Ethereal-Space-Inc/esi-science-card-hardware/mcxn-proto-card/oresat-proto-card.kicad_pcb

## KiCad design mcxn-proto-card/oresat-proto-card.kicad_pcb (2026-07-07)

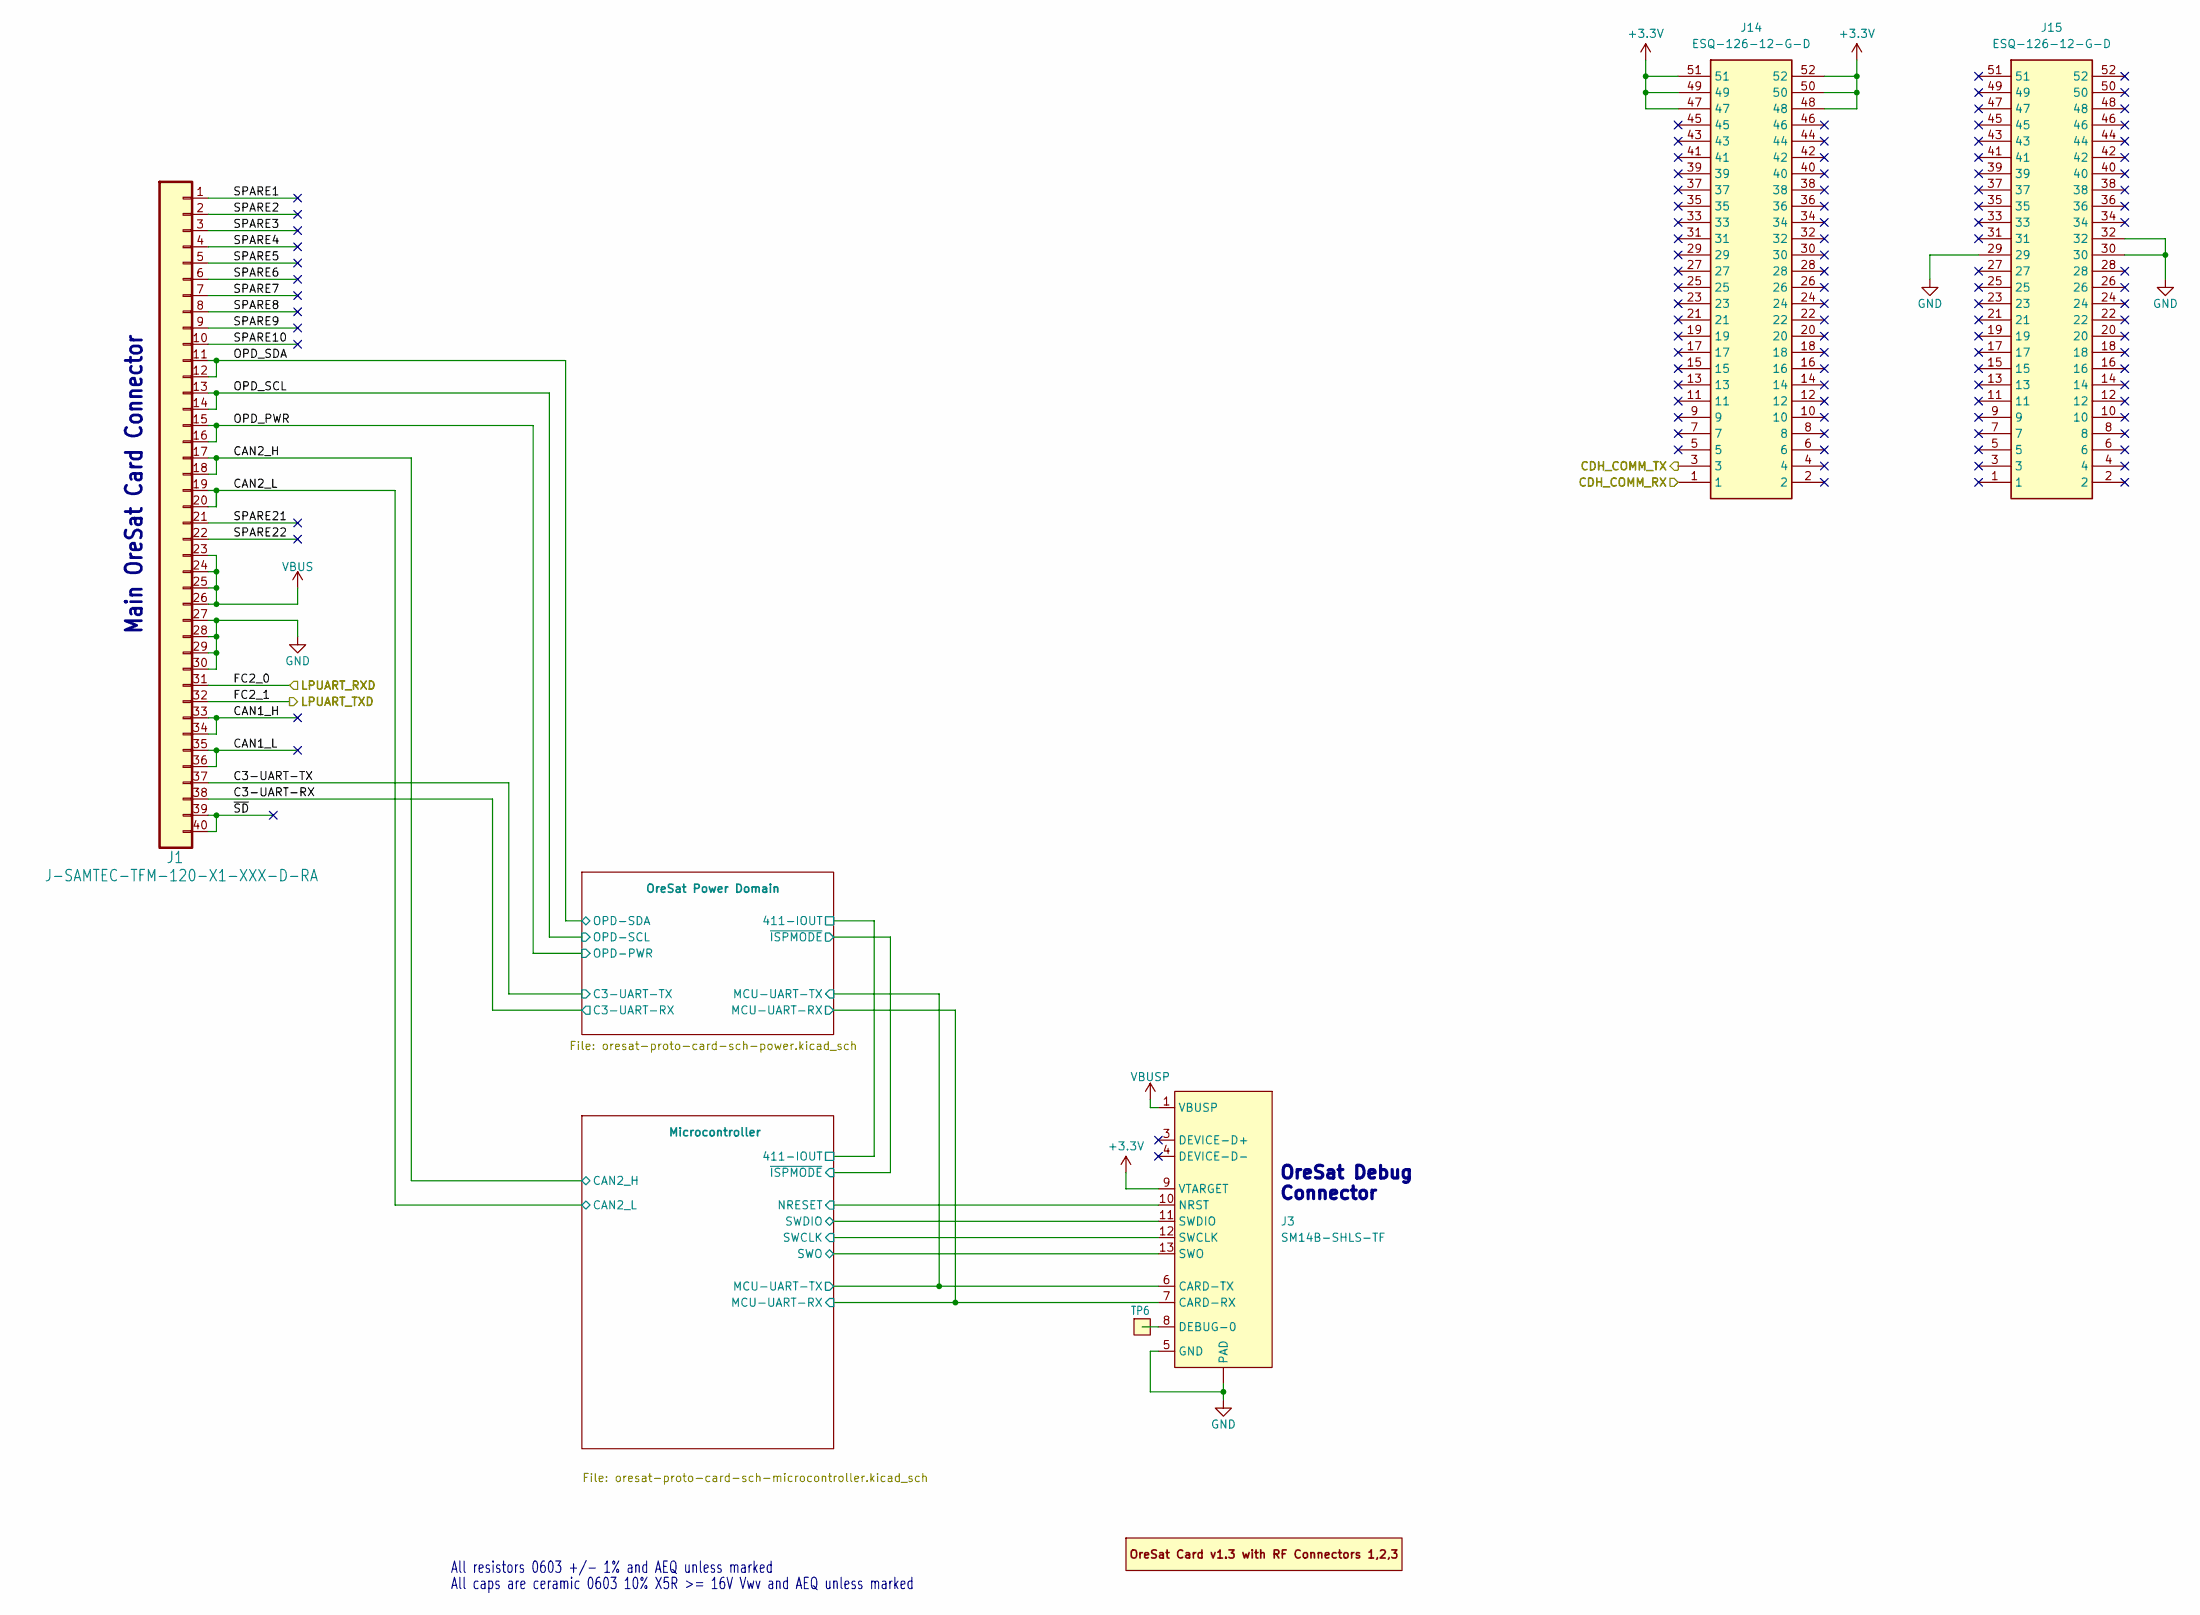
[picture p1: schematic oresat-proto-card.kicad_sch, OreSat MCXN Proto Card]

Parts:
J1: J-SAMTEC-TFM-120-X1-XXX-D-RA; MPN TFM-120-01-L-D-RA
J3: SM14B-SHLS-TF; J-JST-SM14BSHLSTF; MPN SM14B-SHLS-TF
J14, J15: ESQ-126-12-G-D; ESQ-126-Y-X-D; Mouser Part Number 200-ESQ12612GD
PCB1: ORESAT-CARD-V1.3-3RF; MPN oresat-proto-card-v6.0-2025-12-28
TP6: Test-Point; TestPoint-0.75mm-th

Connections:
+3.3V: J3.9 (VTARGET), J14.47, J14.48, J14.49, J14.50, J14.51, J14.52; also elsewhere on the board
/C3-UART-RX: J1.38; also elsewhere on the board
/C3-UART-TX: J1.37; also elsewhere on the board
/CAN1_H: J1.33, J1.34; also elsewhere on the board
/CAN1_L: J1.35, J1.36; also elsewhere on the board
/CAN2_H: J1.17, J1.18; also elsewhere on the board
/CAN2_L: J1.19, J1.20; also elsewhere on the board
/Microcontroller/CDH_COMM_RX: J14.1; also elsewhere on the board
/Microcontroller/CDH_COMM_TX: J14.3; also elsewhere on the board
/Microcontroller/FC2_0: J1.31; also elsewhere on the board
/Microcontroller/FC2_1: J1.32; also elsewhere on the board
/Microcontroller/MCU-UART-RX: J3.7 (CARD-RX); also elsewhere on the board
/Microcontroller/MCU-UART-TX: J3.6 (CARD-TX); also elsewhere on the board
/Microcontroller/NRESET: J3.10 (NRST); also elsewhere on the board
/Microcontroller/SWCLK: J3.12 (SWCLK); also elsewhere on the board
/Microcontroller/SWDIO: J3.11 (SWDIO); also elsewhere on the board
/Microcontroller/SWO: J3.13 (SWO); also elsewhere on the board
/OPD_PWR: J1.15, J1.16; also elsewhere on the board
/OPD_SCL: J1.13, J1.14; also elsewhere on the board
/OPD_SDA: J1.11, J1.12; also elsewhere on the board
/SPARE1: J1.1; also elsewhere on the board
/SPARE2: J1.2; also elsewhere on the board
/SPARE3: J1.3; also elsewhere on the board
/SPARE4: J1.4; also elsewhere on the board
/SPARE5: J1.5; also elsewhere on the board
/SPARE6: J1.6; also elsewhere on the board
/SPARE7: J1.7; also elsewhere on the board
/SPARE8: J1.8; also elsewhere on the board
/SPARE9: J1.9; also elsewhere on the board
/SPARE10: J1.10; also elsewhere on the board
/SPARE21: J1.21; also elsewhere on the board
/SPARE22: J1.22; also elsewhere on the board
/~SD: J1.39, J1.40; also elsewhere on the board
GND: J1.27, J1.28, J1.29, J1.30, J3.5 (GND), J3.14 (GND), J3.15 (PAD), J3.16 (PAD), J15.29, J15.30, J15.32; also elsewhere on the board
unnamed: J3.8 (DEBUG-0), TP6.1 (1_1)
VBUS: J1.23, J1.24, J1.25, J1.26; also elsewhere on the board
VBUSP: J3.1 (VBUSP), J3.2 (VBUSP); also elsewhere on the board

Notes on the sheet:
All caps are ceramic 0603 10% X5R >= 16V Vwv and AEQ unless marked
All resistors 0603 +/- 1% and AEQ unless marked
OreSat Debug Connector
Main OreSat Card Connector

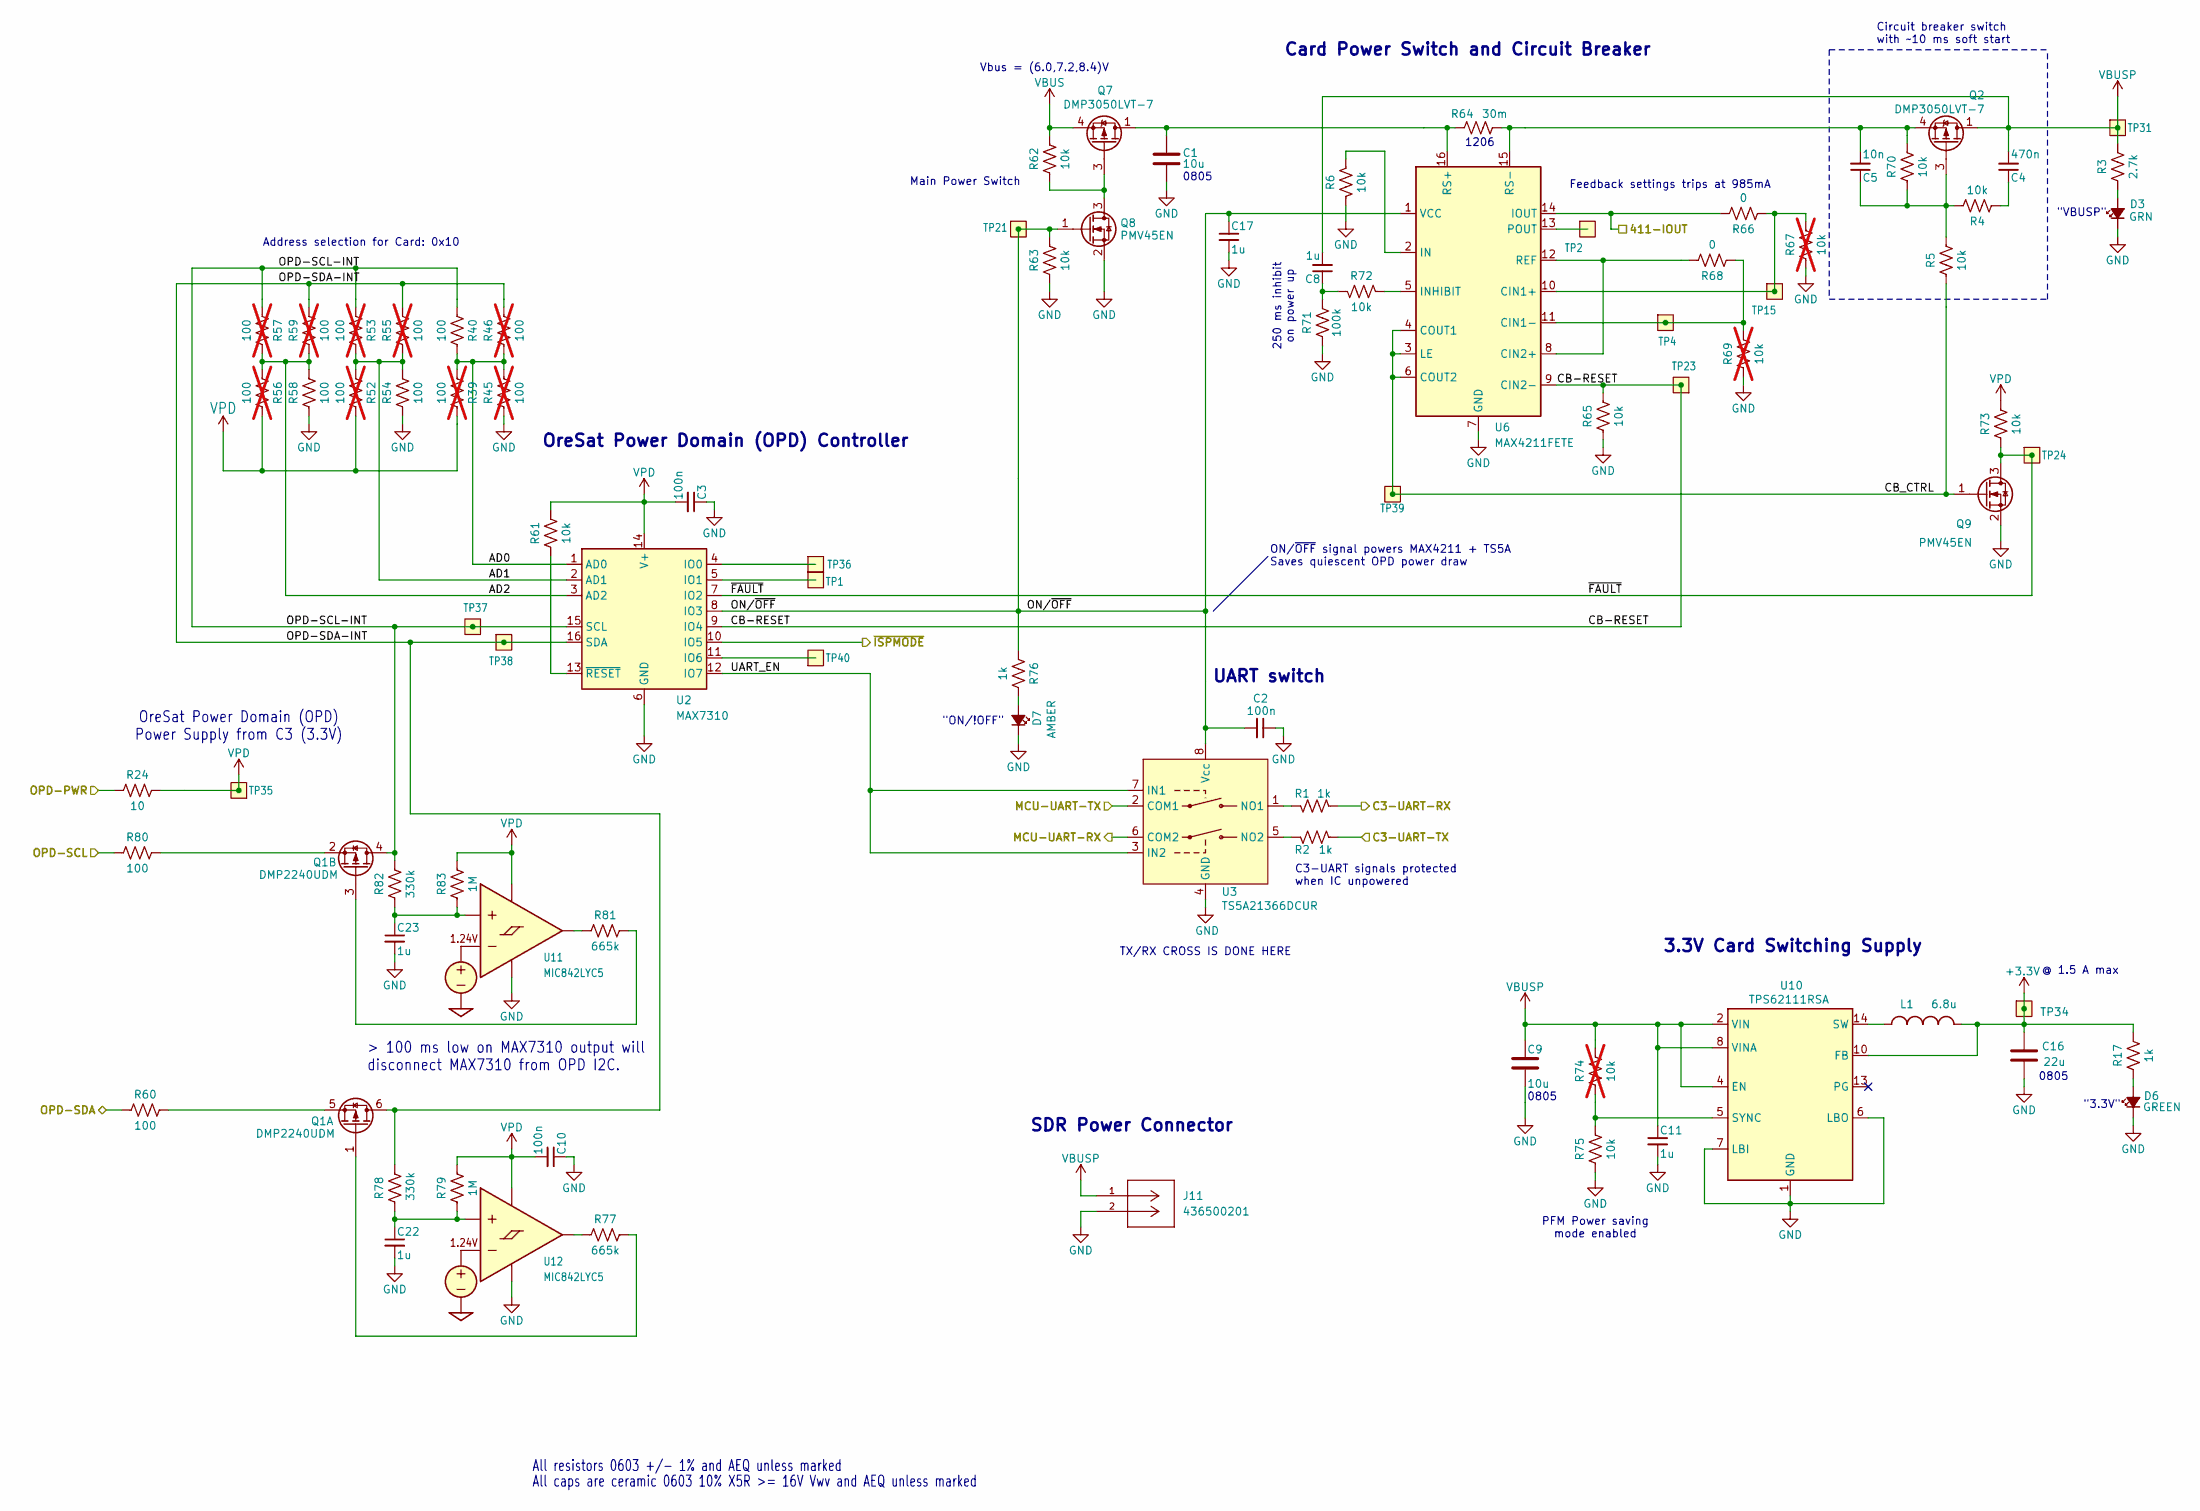
[picture p2: schematic oresat-proto-card-sch-power.kicad_sch, OreSat MCXN Proto Card]

Parts:
C1, C9: 10u; 0805-B-NOSILK; MPN GRT21BC71E106KE13K
C2, C3, C10: 100n; 0603-C-NOSILK; MPN C0603C104K5RACAUTO
C4: 470n; 0603-C-NOSILK; MPN C0603C474K3RACAUTO
C5: 10n; 0603-C-NOSILK; MPN C0603C103K5RACAUTO
C8, C11, C17, C22, C23: 1u; 0603-C-NOSILK; MPN GRT188R71E105KE13D
C16: 22u; 0805-C-NOSILK; MPN GRT21BC81C226ME13L
D3: GRN; LED_0603_1608Metric; MPN 150060GS75000
D6: GREEN; LED_0603_1608Metric; MPN 150060GS75000
D7: AMBER; LED_0603_1608Metric; MPN 150060AS75000
J11: 436500201; CONN_SD-43650-001_02_MOL; Manufacturer_Part_Number 436500201
L1: 6.8u; L_ECS-MPI4040; MPN ECS-MPI4040R4-6R8-R
Q1: DMP2240UDM; SOT-23-6; MPN DMP2240UDM
Q2, Q7: DMP3050LVT-7; TSOT-23-6; MPN DMP3050LVT-7
Q8, Q9: PMV45EN; SOT-23; MPN PMV45EN2R
R1, R2, R17, R76: 1k; 0603-C-NOSILK; MPN RMCF0603FT1K00
R3: 2.7k; 0603-C-NOSILK; MPN RMCF0603FT2K70
R4, R5, R6, R61, R62, R63, R65, R70, R72, R73, R75: 10k; 0603-C-NOSILK; MPN RMCF0603FT10K0
R24: 10; 0603-C-NOSILK; MPN RMCF0603FT10R0
R39, R45, R46, R52, R53, R55, R56, R57, R59: 100; 0603-C-NOSILK; MPN RMCF0603FT100R; not fitted
R40, R54, R58, R60, R80: 100; 0603-C-NOSILK; MPN RMCF0603FT100R
R64: 30m; R_1206_3216Metric; MPN CSR1206FK30L0
R66, R68: 0; 0603-C-NOSILK; MPN RMCF0603ZT0R00
R67, R69, R74: 10k; 0603-C-NOSILK; MPN RMCF0603FT10K0; not fitted
R71: 100k; 0603-C-NOSILK; MPN RMCF0603FT100K
R77, R81: 665k; 0603-C-NOSILK; MPN RMCF0603FT665K
R78, R82: 330k; 0603-C-NOSILK; MPN RMCF0603FT330K
R79, R83: 1M; 0603-C-NOSILK; MPN RMCF0603FT1M00
TP1, TP2, TP4, TP15, TP21, TP23, TP24, TP31, TP34, TP35, TP36, TP37, TP38, TP39, TP40: Test-Point; TestPoint-0.75mm-th
U2: MAX7310; QFN-16-1EP_4x4mm_P0.65mm_EP2.1x2.1mm; MPN MAX7310ATE
U3: TS5A21366DCUR; VSSOP-8_2.3x2mm_P0.5mm; MPN TS5A21366DCUR
U6: MAX4211FETE; QFN-16-1EP_4x4mm_P0.65mm_EP2.1x2.1mm; MPN MAX4211FETE
U10: TPS62111RSA; Texas_RSA_VQFN-16-1EP_4x4mm_P0.65mm_EP2.7x2.7mm; MPN TPS62111RSA
U11, U12: MIC842LYC5; SOT-353_SC-70-5; MPN MIC842LYC5-TR

Connections:
+3.3V: C16.1, L1.2, R17.2, TP34.1 (1_1), U10.10 (FB); also elsewhere on the board
/C3-UART-RX: R1.1; also elsewhere on the board
/C3-UART-TX: R2.1; also elsewhere on the board
/Microcontroller/411-IOUT: R66.2, U6.14 (IOUT); also elsewhere on the board
/Microcontroller/MCU-UART-RX: U3.6 (COM2); also elsewhere on the board
/Microcontroller/MCU-UART-TX: U3.2 (COM1); also elsewhere on the board
/Microcontroller/~ISPMODE: U2.10 (IO5); also elsewhere on the board
/OPD_PWR: R24.1; also elsewhere on the board
/OPD_SCL: R80.1; also elsewhere on the board
/OPD_SDA: R60.1; also elsewhere on the board
/OreSat Power Domain/AD0: R39.1, R40.2, R45.2, R46.1, U2.1 (AD0)
/OreSat Power Domain/AD1: R52.1, R53.2, R54.2, R55.1, U2.2 (AD1)
/OreSat Power Domain/AD2: R56.1, R57.2, R58.2, R59.1, U2.3 (AD2)
/OreSat Power Domain/CB-RESET: R65.2, TP23.1 (1_1), U2.9 (IO4), U6.9 (CIN2-)
/OreSat Power Domain/CB_CTRL: Q9.1 (G), R5.1, TP39.1 (1_1), U6.3 (LE), U6.4 (COUT1), U6.6 (COUT2)
/OreSat Power Domain/ON/~OFF: C2.2, C17.1, Q8.1 (G), R63.2, R76.1, TP21.1 (1_1), U2.8 (IO3), U3.8 (Vcc), U6.1 (VCC)
/OreSat Power Domain/OPD-SCL-INT: Q1.4 (D), R40.1, R53.1, R57.1, R82.2, TP37.1 (1_1), U2.15 (SCL)
/OreSat Power Domain/OPD-SDA-INT: Q1.6 (D), R46.2, R55.2, R59.2, R78.2, TP38.1 (1_1), U2.16 (SDA)
/OreSat Power Domain/UART_EN: U2.12 (IO7), U3.3 (IN2), U3.7 (IN1)
/OreSat Power Domain/~FAULT: Q9.3 (D), R73.1, TP24.1 (1_1), U2.7 (IO2)
GND: C1.2, C2.1, C3.1, C9.2, C10.1, C11.2, C16.2, C17.2, C22.2, C23.2, D3.1 (K), D6.1 (K), D7.1 (K), J11.2, Q8.2 (S), Q9.2 (S), R6.2, R45.1, R54.1, R58.1, R63.1, R65.1, R67.1, R69.1, R71.1, R75.1, U2.6 (GND), U2.17 (GND), U3.4 (GND), U6.7 (GND), U6.17 (GND), U10.1 (GND), U10.6 (LBO), U10.7 (LBI), U10.9 (GND), U10.11 (GND), U10.12 (GND), U10.16 (GND), U10.17 (GND), U11.2 (GND), U12.2 (GND); also elsewhere on the board
unnamed: C4.1, R4.1
unnamed: C8.1, R71.2, R72.2
unnamed: D3.2 (A), R3.1
unnamed: D6.2 (A), R17.1
unnamed: D7.2 (A), R76.2
unnamed: L1.1, U10.14 (SW), U10.15 (SW)
unnamed: Q1.1 (G), R77.2
unnamed: Q1.5 (S), R60.2
unnamed: Q1.3 (G), R81.2
unnamed: Q1.2 (S), R80.2
unnamed: C5.1, Q2.3 (G), R4.2, R5.2, R70.1
unnamed: C5.2, Q2.4 (S), R64.2, R70.2, U6.15 (RS-)
unnamed: Q7.3 (G), Q8.3 (D), R62.1
unnamed: TP36.1 (1_1), U2.4 (IO0)
unnamed: TP1.1 (1_1), U2.5 (IO1)
unnamed: TP40.1 (1_1), U2.11 (IO6)
unnamed: R61.1, U2.13 (~RESET)
unnamed: R1.2, U3.1 (NO1)
unnamed: R2.2, U3.5 (NO2)
unnamed: R66.1, R67.2, TP15.1 (1_1), U6.10 (CIN1+)
unnamed: R68.1, R69.2, TP4.1 (1_1), U6.11 (CIN1-)
unnamed: R68.2, U6.8 (CIN2+), U6.12 (REF)
unnamed: R6.1, U6.2 (IN)
unnamed: R72.1, U6.5 (INHIBIT)
unnamed: TP2.1 (1_1), U6.13 (POUT)
unnamed: C1.1, Q7.1 (D), Q7.2 (D), Q7.5 (D), Q7.6 (D), R64.1, U6.16 (RS+)
unnamed: R74.1, R75.2, U10.5 (SYNC)
unnamed: C23.1, R82.1, R83.1, U11.1 (INP)
unnamed: R81.1, U11.4 (OUT)
unnamed: C22.1, R78.1, R79.1, U12.1 (INP)
unnamed: R77.1, U12.4 (OUT)
VBUS: Q7.4 (S), R62.2; also elsewhere on the board
VBUSP: C4.2, C8.2, C9.1, C11.1, J11.1, Q2.1 (D), Q2.2 (D), Q2.5 (D), Q2.6 (D), R3.2, R74.2, TP31.1 (1_1), U10.2 (VIN), U10.3 (VIN), U10.4 (EN), U10.8 (VINA); also elsewhere on the board
VPD: C3.2, C10.2, R24.2, R39.2, R52.2, R56.2, R61.2, R73.2, R79.2, R83.2, TP35.1 (1_1), U2.14 (V+), U11.5 (VDD), U12.5 (VDD)

Notes on the sheet:
ON/~{OFF} signal powers MAX4211 + TS5A Saves quiescent OPD power draw
Feedback settings trips at 985mA
Card Power Switch and Circuit Breaker
1206
3.3V Card Switching Supply
"3.3V"
> 100 ms low on MAX7310 output will disconnect MAX7310 from OPD I2C.
SDR Power Connector
C3-UART signals protected when IC unpowered
OreSat Power Domain (OPD) Power Supply from C3 (3.3V)
Vbus = (6.0,7.2,8.4)V
All resistors 0603 +/- 1% and AEQ unless marked
0805
OreSat Power Domain (OPD) Controller
"VBUSP"
All caps are ceramic 0603 10% X5R >= 16V Vwv and AEQ unless marked
250 ms inhibit on power up
@ 1.5 A max
PFM Power saving mode enabled
"ON/!OFF"
TX/RX CROSS IS DONE HERE
Address selection for Card: 0x10
Circuit breaker switch with ~10 ms soft start
Main Power Switch
UART switch

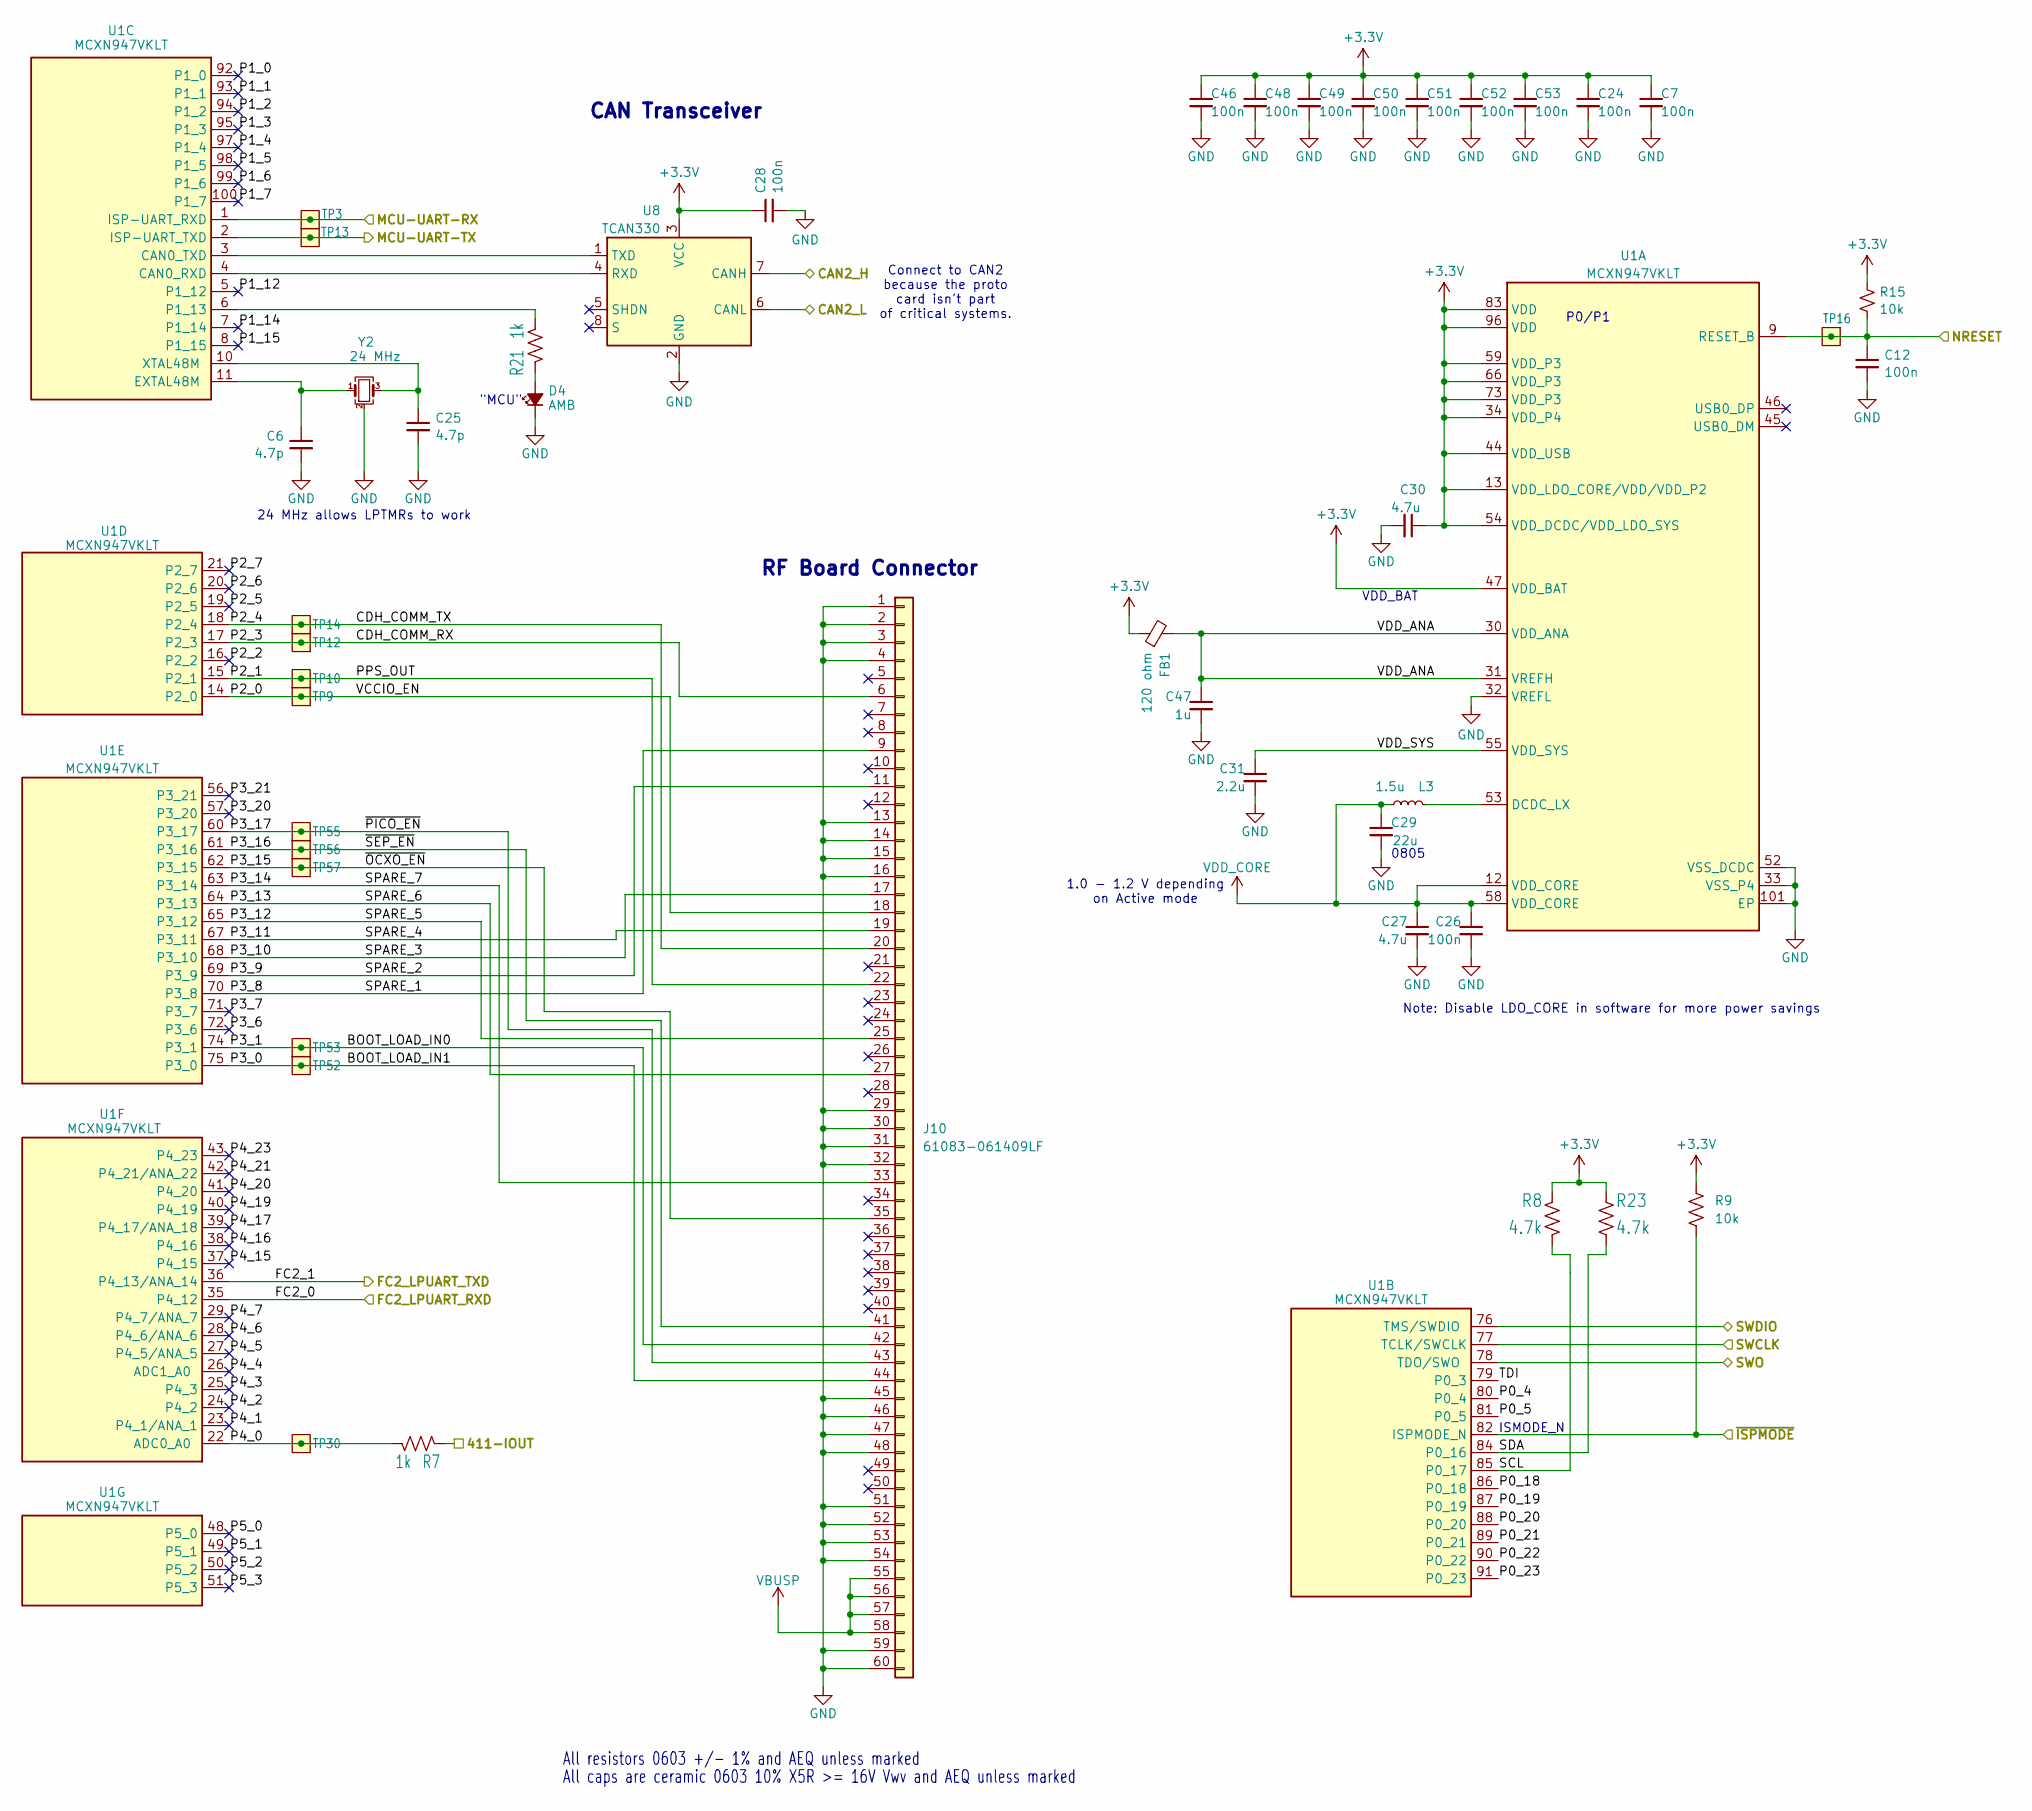
[picture p3: schematic oresat-proto-card-sch-microcontroller.kicad_sch, OreSat MCXN Proto Card]

Parts:
C6, C25: 4.7p; 0603-C-NOSILK; MPN C0603C479D5GACAUTO
C7, C12, C24, C26, C28, C46, C48, C49, C50, C51, C52, C53: 100n; 0603-C-NOSILK; MPN C0603C104K5RACAUTO
C27, C30: 4.7u; 0603-C-NOSILK; MPN EMK107BBJ475KAHT
C29: 22u; 0805-C-NOSILK; MPN GRT21BC81C226ME13L
C31: 2.2u; 0603-C-NOSILK; MPN GRT188C71E225KE13D
C47: 1u; 0603-C-NOSILK; MPN GRT188R71E105KE13D
D4: AMB; LED_0603_1608Metric; MPN 150060AS75000
FB1: 120 ohm; 0805-B-NOSILK; MPN 2508051217Y6
J10: 61083-061409LF; AMPHENOL_61083-061409LF
L3: 1.5u; L_0805_2012Metric; MPN SRP2012TMA-1R5M
R7, R21: 1k; 0603-C-NOSILK; MPN RMCF0603FT1K00
R8, R23: 4.7k; 0603-C-NOSILK; MPN RMCF0603FT4K70
R9, R15: 10k; 0603-C-NOSILK; MPN RMCF0603FT10K0
TP3, TP9, TP10, TP12, TP13, TP14, TP16, TP30, TP52, TP53, TP55, TP56, TP57: Test-Point; TestPoint-0.75mm-th
U1: MCXN947VKLT; MCXN947KVLT-QFP50P1600X1600X160-101N; MPN MCXN947VKLT
U8: TCAN330; SOT-23-8; MPN TCAN330DCNR
Y2: 24 MHz; Crystal_SMD_2016-4Pin_2.0x1.6mm; MPN 830108212309

Connections:
+3.3V: C7.1, C24.1, C28.1, C30.1, C46.1, C48.1, C49.1, C50.1, C51.1, C52.1, C53.1, FB1.1, R8.2, R9.2, R15.2, R23.2, U1.13 (VDD_LDO_CORE/VDD/VDD_P2), U1.34 (VDD_P4), U1.44 (VDD_USB), U1.47 (VDD_BAT), U1.54 (VDD_DCDC/VDD_LDO_SYS), U1.59 (VDD_P3), U1.66 (VDD_P3), U1.73 (VDD_P3), U1.83 (VDD), U1.96 (VDD), U8.3 (VCC); also elsewhere on the board
/CAN2_H: U8.7 (CANH); also elsewhere on the board
/CAN2_L: U8.6 (CANL); also elsewhere on the board
/Microcontroller/411-IOUT: R7.2; also elsewhere on the board
/Microcontroller/CDH_COMM_RX: J10.6, TP12.1 (1_1), U1.17 (P2_3); also elsewhere on the board
/Microcontroller/CDH_COMM_TX: J10.20, TP14.1 (1_1), U1.18 (P2_4); also elsewhere on the board
/Microcontroller/FC2_0: U1.35 (P4_12); also elsewhere on the board
/Microcontroller/FC2_1: U1.36 (P4_13/ANA_14); also elsewhere on the board
/Microcontroller/MCU-UART-RX: TP3.1 (1_1), U1.1 (ISP-UART_RXD); also elsewhere on the board
/Microcontroller/MCU-UART-TX: TP13.1 (1_1), U1.2 (ISP-UART_TXD); also elsewhere on the board
/Microcontroller/NRESET: C12.1, R15.1, TP16.1 (1_1), U1.9 (RESET_B); also elsewhere on the board
/Microcontroller/P0_4: U1.80 (P0_4)
/Microcontroller/P0_5: U1.81 (P0_5)
/Microcontroller/P0_18: U1.86 (P0_18)
/Microcontroller/P0_19: U1.87 (P0_19)
/Microcontroller/P0_20: U1.88 (P0_20)
/Microcontroller/P0_21: U1.89 (P0_21)
/Microcontroller/P0_22: U1.90 (P0_22)
/Microcontroller/P0_23: U1.91 (P0_23)
/Microcontroller/P1_0: U1.92 (P1_0)
/Microcontroller/P1_1: U1.93 (P1_1)
/Microcontroller/P1_2: U1.94 (P1_2)
/Microcontroller/P1_3: U1.95 (P1_3)
/Microcontroller/P1_4: U1.97 (P1_4)
/Microcontroller/P1_5: U1.98 (P1_5)
/Microcontroller/P1_6: U1.99 (P1_6)
/Microcontroller/P1_7: U1.100 (P1_7)
/Microcontroller/P1_12: U1.5 (P1_12)
/Microcontroller/P1_14: U1.7 (P1_14)
/Microcontroller/P1_15: U1.8 (P1_15)
/Microcontroller/P2_0: J10.18, TP9.1 (1_1), U1.14 (P2_0)
/Microcontroller/P2_1: J10.22, TP10.1 (1_1), U1.15 (P2_1)
/Microcontroller/P2_2: U1.16 (P2_2)
/Microcontroller/P2_5: U1.19 (P2_5)
/Microcontroller/P2_6: U1.20 (P2_6)
/Microcontroller/P2_7: U1.21 (P2_7)
/Microcontroller/P3_6: U1.72 (P3_6)
/Microcontroller/P3_7: U1.71 (P3_7)
/Microcontroller/P3_8: J10.9, U1.70 (P3_8)
/Microcontroller/P3_9: J10.11, U1.69 (P3_9)
/Microcontroller/P3_10: J10.17, U1.68 (P3_10)
/Microcontroller/P3_11: J10.19, U1.67 (P3_11)
/Microcontroller/P3_12: J10.25, U1.65 (P3_12)
/Microcontroller/P3_13: J10.27, U1.64 (P3_13)
/Microcontroller/P3_14: J10.33, U1.63 (P3_14)
/Microcontroller/P3_15: J10.35, TP57.1 (1_1), U1.62 (P3_15)
/Microcontroller/P3_16: J10.41, TP56.1 (1_1), U1.61 (P3_16)
/Microcontroller/P3_17: J10.43, TP55.1 (1_1), U1.60 (P3_17)
/Microcontroller/P3_20: U1.57 (P3_20)
/Microcontroller/P3_21: U1.56 (P3_21)
/Microcontroller/P4_0: R7.1, TP30.1 (1_1), U1.22 (ADC0_A0)
/Microcontroller/P4_1: U1.23 (P4_1/ANA_1)
/Microcontroller/P4_2: U1.24 (P4_2)
/Microcontroller/P4_3: U1.25 (P4_3)
/Microcontroller/P4_4: U1.26 (ADC1_A0)
/Microcontroller/P4_5: U1.27 (P4_5/ANA_5)
/Microcontroller/P4_6: U1.28 (P4_6/ANA_6)
/Microcontroller/P4_7: U1.29 (P4_7/ANA_7)
/Microcontroller/P4_15: U1.37 (P4_15)
/Microcontroller/P4_16: U1.38 (P4_16)
/Microcontroller/P4_17: U1.39 (P4_17/ANA_18)
/Microcontroller/P4_19: U1.40 (P4_19)
/Microcontroller/P4_20: U1.41 (P4_20)
/Microcontroller/P4_21: U1.42 (P4_21/ANA_22)
/Microcontroller/P4_23: U1.43 (P4_23)
/Microcontroller/P5_0: U1.48 (P5_0)
/Microcontroller/P5_1: U1.49 (P5_1)
/Microcontroller/P5_2: U1.50 (P5_2)
/Microcontroller/P5_3: U1.51 (P5_3)
/Microcontroller/SCL: R8.1, U1.85 (P0_17)
/Microcontroller/SDA: R23.1, U1.84 (P0_16)
/Microcontroller/SWCLK: U1.77 (TCLK/SWCLK); also elsewhere on the board
/Microcontroller/SWDIO: U1.76 (TMS/SWDIO); also elsewhere on the board
/Microcontroller/SWO: U1.78 (TDO/SWO); also elsewhere on the board
/Microcontroller/TDI: U1.79 (P0_3)
/Microcontroller/VDD_ANA: C47.1, FB1.2, U1.30 (VDD_ANA), U1.31 (VREFH)
/Microcontroller/VDD_SYS: C31.1, U1.55 (VDD_SYS)
/Microcontroller/~ISPMODE: R9.1, U1.82 (ISPMODE_N); also elsewhere on the board
GND: C6.2, C7.2, C12.2, C24.2, C25.2, C26.2, C27.2, C28.2, C29.2, C30.2, C31.2, C46.2, C47.2, C48.2, C49.2, C50.2, C51.2, C52.2, C53.2, D4.1 (K), J10.1, J10.2, J10.3, J10.4, J10.13, J10.14, J10.15, J10.16, J10.29, J10.30, J10.31, J10.32, J10.45, J10.46, J10.47, J10.48, J10.51, J10.52, J10.53, J10.54, J10.59, J10.60, U1.32 (VREFL), U1.33 (VSS_P4), U1.52 (VSS_DCDC), U1.101 (EP), U8.2 (GND), Y2.2 (G), Y2.4 (G); also elsewhere on the board
unnamed: D4.2 (A), R21.2
unnamed: L3.2, U1.53 (DCDC_LX)
unnamed: U1.3 (CAN0_TXD), U8.1 (TXD)
unnamed: U1.4 (CAN0_RXD), U8.4 (RXD)
unnamed: R21.1, U1.6 (P1_13)
unnamed: C25.1, U1.10 (XTAL48M), Y2.3
unnamed: C6.1, U1.11 (EXTAL48M), Y2.1
VBUSP: J10.55, J10.56, J10.57, J10.58; also elsewhere on the board
VDD_CORE: C26.1, C27.1, C29.1, L3.1, U1.12 (VDD_CORE), U1.58 (VDD_CORE)

Notes on the sheet:
Connect to CAN2 because the proto card isn't part of critical systems.
All caps are ceramic 0603 10% X5R >= 16V Vwv and AEQ unless marked
Note: Disable LDO_CORE in software for more power savings
All resistors 0603 +/- 1% and AEQ unless marked
24 MHz allows LPTMRs to work
0805
1.0 - 1.2 V depending on Active mode
VDD_BAT
"MCU"
P0/P1
ISMODE_N
RF Board Connector
CAN Transceiver

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
