Ethereal-Space-Inc/esi-science-card-hardware/mcxn-proto-card/oresat-proto-card.kicad_pcb

## KiCad design mcxn-proto-card/oresat-proto-card.kicad_pcb (continued)

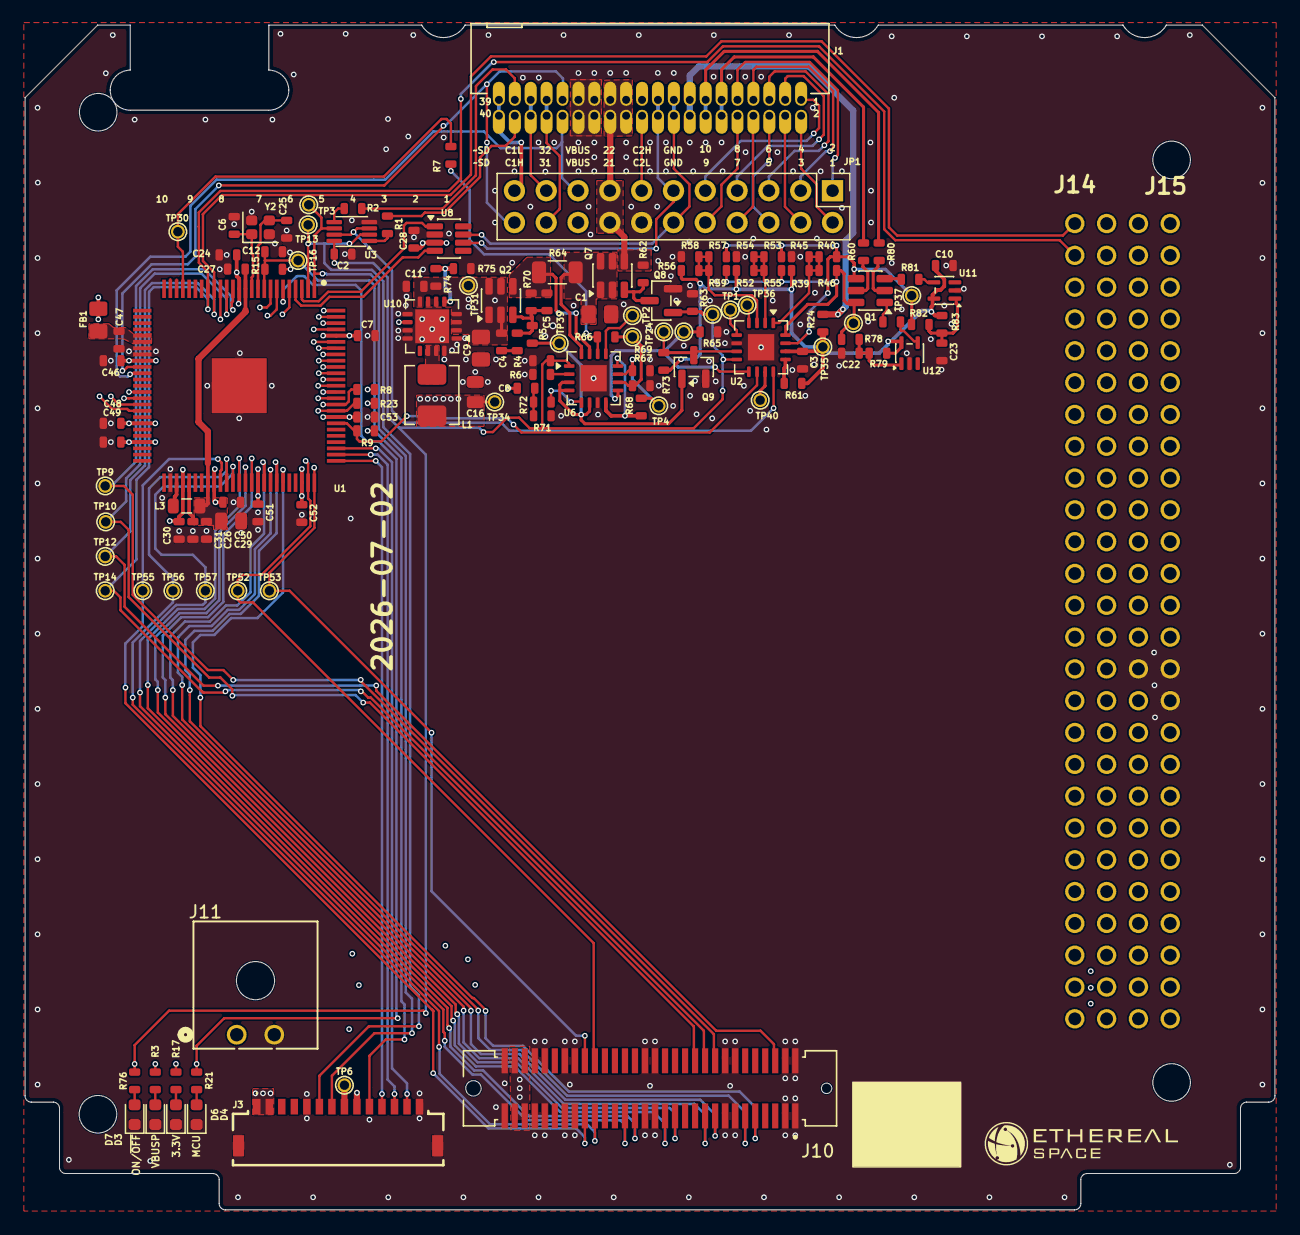
[picture p4: board oresat-proto-card.kicad_pcb from above]

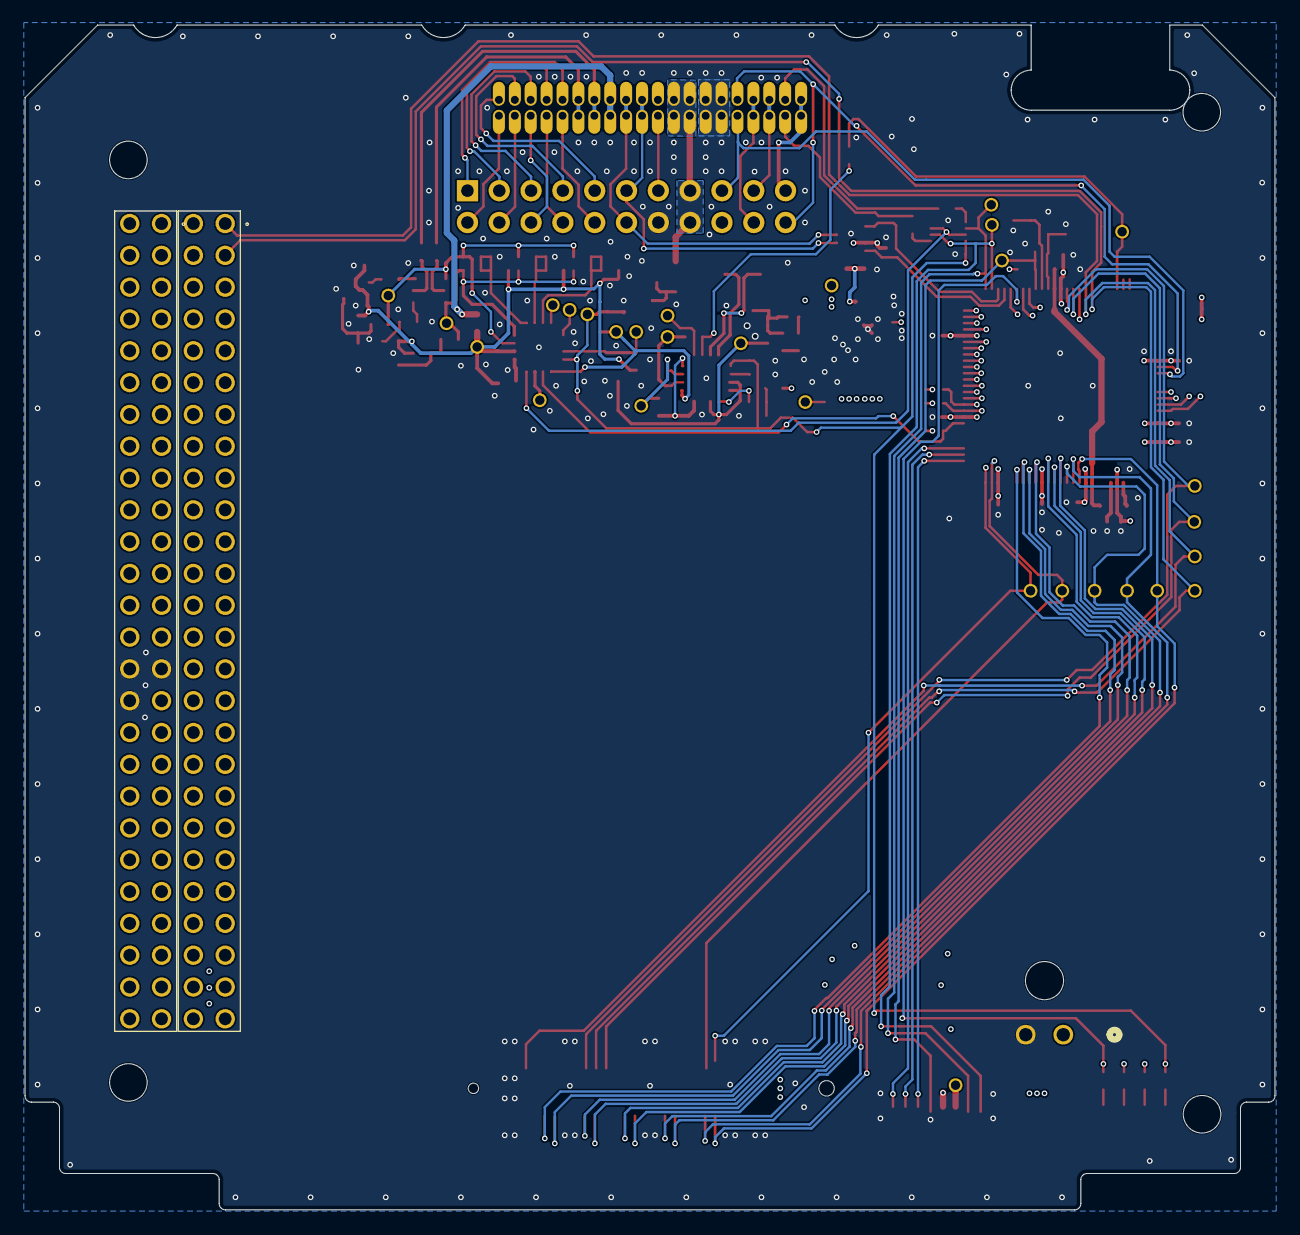
[picture p5: board oresat-proto-card.kicad_pcb from below]

Board: 4 copper layers, 99.8 x 94.6 mm, 140 parts (2 on the bottom side), 108 nets.

Other parts of the board:
JP1: PINHD-2X5; PinHeader_2x11_P2.54mm_Vertical

Their connections:
/CAN1_H: JP1.20; also elsewhere on the board
/CAN1_L: JP1.19; also elsewhere on the board
/CAN2_H: JP1.12; also elsewhere on the board
/CAN2_L: JP1.11; also elsewhere on the board
/Microcontroller/FC2_0: JP1.22; also elsewhere on the board
/Microcontroller/FC2_1: JP1.17; also elsewhere on the board
/SPARE1: JP1.9; also elsewhere on the board
/SPARE2: JP1.2; also elsewhere on the board
/SPARE3: JP1.7; also elsewhere on the board
/SPARE4: JP1.4; also elsewhere on the board
/SPARE5: JP1.5; also elsewhere on the board
/SPARE6: JP1.6; also elsewhere on the board
/SPARE7: JP1.3; also elsewhere on the board
/SPARE8: JP1.8; also elsewhere on the board
/SPARE9: JP1.1; also elsewhere on the board
/SPARE10: JP1.10; also elsewhere on the board
/SPARE21: JP1.18; also elsewhere on the board
/SPARE22: JP1.13; also elsewhere on the board
/~SD: JP1.21; also elsewhere on the board
GND: JP1.14; also elsewhere on the board
VBUS: JP1.15, JP1.16; also elsewhere on the board
