Ethereal-Space-Inc/esi-science-card-hardware/(commit log)

2026-07-05 First commit of Science Card
    [oresat-proto-card-sch-microcontroller.kicad_sch, oresat-proto-card-sch-power.kicad_sch, oresat-proto-card.kicad_pcb, oresat-proto-card.kicad_sch]
2026-07-06 Added power P3.3V planes
    [oresat-proto-card.kicad_pcb]
2026-07-06 ADjusted J14 and J15 placement for piPlasma alignment. Added ESI logo.
    [oresat-proto-card-sch-power.kicad_sch, oresat-proto-card.kicad_pcb]
2026-07-06 Added mounting holes for piPlasma
    [oresat-proto-card.kicad_pcb]
2026-07-07 Adjusted RF connection
    [oresat-proto-card.kicad_pcb]
2026-07-07 Finalized design with adding properly measured mounting holes that line up with piPlasma.
    [oresat-proto-card.kicad_pcb]
2026-07-07 Finalized design with adding properly measured mounting holes that line up with piPlasma. As well as changing sense resistor to allow 1A trip
    [oresat-proto-card-sch-power.kicad_sch, oresat-proto-card.kicad_pcb]
